nangelFHTW/Boehler2024/CAD/Produkt/Part2_scaled.SLDPRT

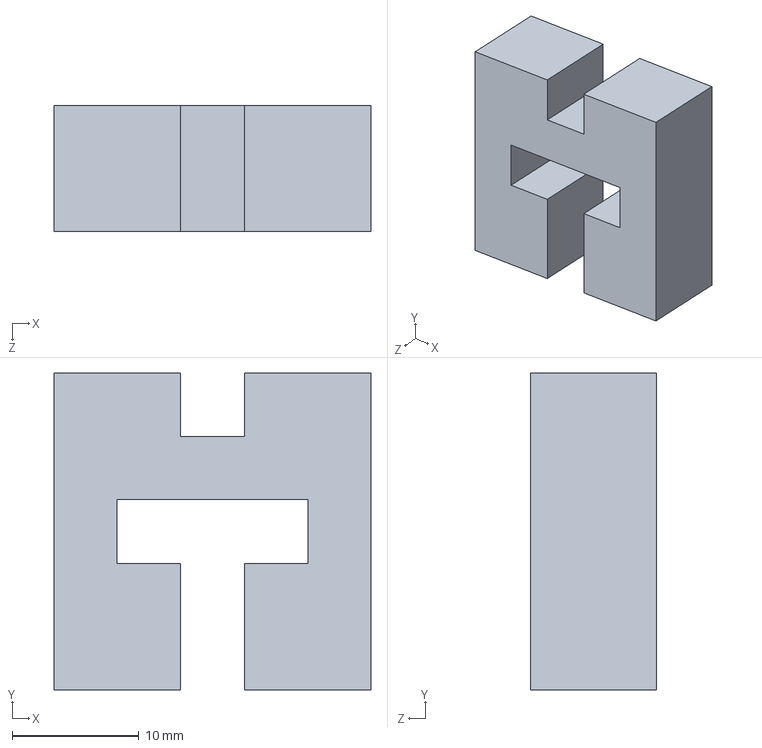
[picture p15: CAD file, 2024-03-08]
CAD/Produkt/Part2_scaled.SLDPRT
25.0 x 25.0 x 9.90 mm
