nangelFHTW/Boehler2024/CAD/Produkt/Part1_scaled.SLDPRT

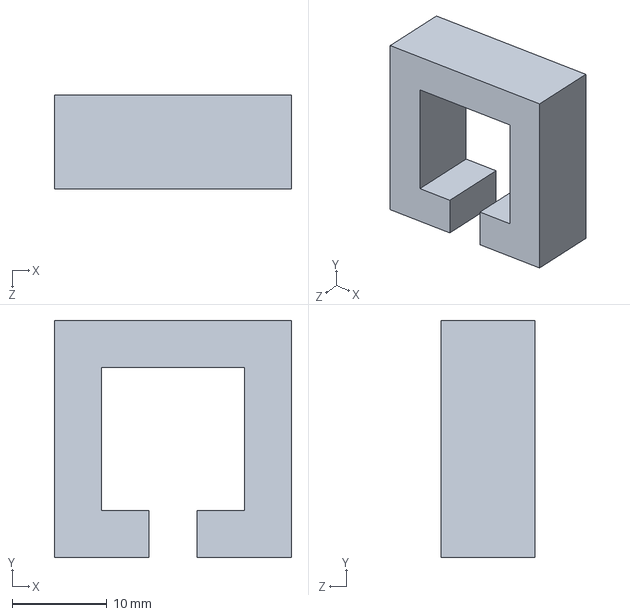
[picture p16: CAD file, 2024-03-08]
CAD/Produkt/Part1_scaled.SLDPRT
25.0 x 25.0 x 9.90 mm
