nangelFHTW/Boehler2024/CAD/Produkt/Part3_scaled.SLDPRT

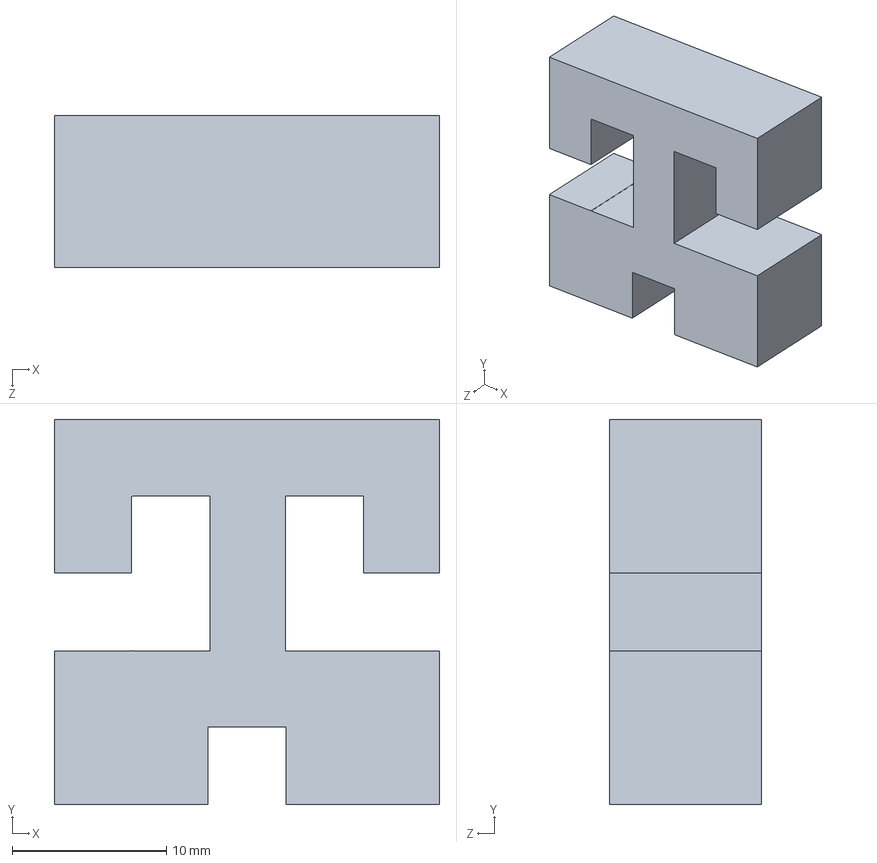
[picture p17: CAD file, 2024-03-08]
CAD/Produkt/Part3_scaled.SLDPRT
25.0 x 25.0 x 9.90 mm
