nangelFHTW/Boehler2024/(list of files, cad)

Other CAD files:
CAD/Produkt/Part1_scaled.STL
CAD/Produkt/Part2_scaled.STL
CAD/Produkt/Part3_scaled.STL
