nangelFHTW/Boehler2024/(commit log)

2024-03-06 Create CAD Dummy
2024-03-08 Create Conveyor Dummy
